yhs1202/ov7670-dice-race/constr/Basys-3-Master.xdc

## This file is a general .xdc for the Basys3 rev B board
## To use it in a project:
## - uncomment the lines corresponding to used pins
## - rename the used ports (in each line, after get_ports) according to the top level signal names in the project

## Clock signal
set_property -dict { PACKAGE_PIN W5   IOSTANDARD LVCMOS33 } [get_ports clk]
create_clock -add -name sys_clk_pin -period 10.00 -waveform {0 5} [get_ports clk]


## Switches
# set_property -dict { PACKAGE_PIN V17   IOSTANDARD LVCMOS33 } [get_ports {filter_sel[0]}]
# set_property -dict { PACKAGE_PIN V16   IOSTANDARD LVCMOS33 } [get_ports {filter_sel[1]}]
# set_property -dict { PACKAGE_PIN W16   IOSTANDARD LVCMOS33 } [get_ports {filter_sel[2]}]
# set_property -dict { PACKAGE_PIN W17   IOSTANDARD LVCMOS33 } [get_ports {filter_sel[3]}]
#set_property -dict { PACKAGE_PIN W15   IOSTANDARD LVCMOS33 } [get_ports {sw[4]}]
#set_property -dict { PACKAGE_PIN V15   IOSTANDARD LVCMOS33 } [get_ports {sw[5]}]
#set_property -dict { PACKAGE_PIN W14   IOSTANDARD LVCMOS33 } [get_ports {sw[6]}] 
#set_property -dict { PACKAGE_PIN W13   IOSTANDARD LVCMOS33 } [get_ports {sw[7]}]
#set_property -dict { PACKAGE_PIN V2    IOSTANDARD LVCMOS33 } [get_ports {sw[8]}]
#set_property -dict { PACKAGE_PIN T3    IOSTANDARD LVCMOS33 } [get_ports {sw[9]}]
#set_property -dict { PACKAGE_PIN T2    IOSTANDARD LVCMOS33 } [get_ports {sw[10]}]
#set_property -dict { PACKAGE_PIN R3    IOSTANDARD LVCMOS33 } [get_ports {sw[11]}]
#set_property -dict { PACKAGE_PIN W2    IOSTANDARD LVCMOS33 } [get_ports {sw[12]}]
#set_property -dict { PACKAGE_PIN U1    IOSTANDARD LVCMOS33 } [get_ports {sw[13]}]
#set_property -dict { PACKAGE_PIN T1    IOSTANDARD LVCMOS33 } [get_ports {sw[14]}]
#set_property -dict { PACKAGE_PIN R2    IOSTANDARD LVCMOS33 } [get_ports {sw[15]}]


## LEDs
set_property -dict { PACKAGE_PIN U16   IOSTANDARD LVCMOS33 } [get_ports {led_output[0]}]
set_property -dict { PACKAGE_PIN E19   IOSTANDARD LVCMOS33 } [get_ports {led_output[1]}]
set_property -dict { PACKAGE_PIN U19   IOSTANDARD LVCMOS33 } [get_ports {led_output[2]}]
set_property -dict { PACKAGE_PIN V19   IOSTANDARD LVCMOS33 } [get_ports {led_output[3]}]
set_property -dict { PACKAGE_PIN W18   IOSTANDARD LVCMOS33 } [get_ports {led_output[4]}]
set_property -dict { PACKAGE_PIN U15   IOSTANDARD LVCMOS33 } [get_ports {led_output[5]}]
set_property -dict { PACKAGE_PIN U14   IOSTANDARD LVCMOS33 } [get_ports {led_output[6]}]
set_property -dict { PACKAGE_PIN V14   IOSTANDARD LVCMOS33 } [get_ports {led_output[7]}]
set_property -dict { PACKAGE_PIN V13   IOSTANDARD LVCMOS33 } [get_ports {led_output[8]}]
set_property -dict { PACKAGE_PIN V3    IOSTANDARD LVCMOS33 } [get_ports {led_output[9]}]
set_property -dict { PACKAGE_PIN W3    IOSTANDARD LVCMOS33 } [get_ports {led_output[10]}]
set_property -dict { PACKAGE_PIN U3    IOSTANDARD LVCMOS33 } [get_ports {led_output[11]}]
set_property -dict { PACKAGE_PIN P3    IOSTANDARD LVCMOS33 } [get_ports {led_output[12]}]
set_property -dict { PACKAGE_PIN N3    IOSTANDARD LVCMOS33 } [get_ports {led_output[13]}]
set_property -dict { PACKAGE_PIN P1    IOSTANDARD LVCMOS33 } [get_ports {led_output[14]}]
set_property -dict { PACKAGE_PIN L1    IOSTANDARD LVCMOS33 } [get_ports {led_output[15]}]


##7 Segment Display
set_property -dict { PACKAGE_PIN W7   IOSTANDARD LVCMOS33 } [get_ports {fnd_data[0]}]
set_property -dict { PACKAGE_PIN W6   IOSTANDARD LVCMOS33 } [get_ports {fnd_data[1]}]
set_property -dict { PACKAGE_PIN U8   IOSTANDARD LVCMOS33 } [get_ports {fnd_data[2]}]
set_property -dict { PACKAGE_PIN V8   IOSTANDARD LVCMOS33 } [get_ports {fnd_data[3]}]
set_property -dict { PACKAGE_PIN U5   IOSTANDARD LVCMOS33 } [get_ports {fnd_data[4]}]
set_property -dict { PACKAGE_PIN V5   IOSTANDARD LVCMOS33 } [get_ports {fnd_data[5]}]
set_property -dict { PACKAGE_PIN U7   IOSTANDARD LVCMOS33 } [get_ports {fnd_data[6]}]

set_property -dict { PACKAGE_PIN V7   IOSTANDARD LVCMOS33 } [get_ports {fnd_data[7]}]

set_property -dict { PACKAGE_PIN U2   IOSTANDARD LVCMOS33 } [get_ports {fnd_com[0]}]
set_property -dict { PACKAGE_PIN U4   IOSTANDARD LVCMOS33 } [get_ports {fnd_com[1]}]
set_property -dict { PACKAGE_PIN V4   IOSTANDARD LVCMOS33 } [get_ports {fnd_com[2]}]
set_property -dict { PACKAGE_PIN W4   IOSTANDARD LVCMOS33 } [get_ports {fnd_com[3]}]


##Buttons
set_property -dict { PACKAGE_PIN U18   IOSTANDARD LVCMOS33 } [get_ports reset]; # center
set_property -dict { PACKAGE_PIN T18   IOSTANDARD LVCMOS33 } [get_ports start_btn]; # up
# set_property -dict { PACKAGE_PIN W19   IOSTANDARD LVCMOS33 } [get_ports dice_valid]; # left
# set_property -dict { PACKAGE_PIN T17   IOSTANDARD LVCMOS33 } [get_ports btnR]; # right
set_property -dict { PACKAGE_PIN U17   IOSTANDARD LVCMOS33 } [get_ports select_option]; # down



##Pmod Header JA
set_property -dict { PACKAGE_PIN J1   IOSTANDARD LVCMOS33 } [get_ports {CAM1_data[7]}];#Sch name = JA1
set_property -dict { PACKAGE_PIN L2   IOSTANDARD LVCMOS33 } [get_ports {CAM1_data[5]}];#Sch name = JA2
set_property -dict { PACKAGE_PIN J2   IOSTANDARD LVCMOS33 } [get_ports {CAM1_data[3]}];#Sch name = JA3
set_property -dict { PACKAGE_PIN G2   IOSTANDARD LVCMOS33 } [get_ports {CAM1_data[1]}];#Sch name = JA4
set_property -dict { PACKAGE_PIN H1   IOSTANDARD LVCMOS33 } [get_ports {CAM1_data[6]}];#Sch name = JA7
set_property -dict { PACKAGE_PIN K2   IOSTANDARD LVCMOS33 } [get_ports {CAM1_data[4]}];#Sch name = JA8
set_property -dict { PACKAGE_PIN H2   IOSTANDARD LVCMOS33 } [get_ports {CAM1_data[2]}];#Sch name = JA9
set_property -dict { PACKAGE_PIN G3   IOSTANDARD LVCMOS33 } [get_ports {CAM1_data[0]}];#Sch name = JA10

##Pmod Header JB
set_property -dict { PACKAGE_PIN A14   IOSTANDARD LVCMOS33 } [get_ports {CAM1_sioc}];#Sch name = JB1
set_property -dict { PACKAGE_PIN A16   IOSTANDARD LVCMOS33 } [get_ports {CAM1_vsync}];#Sch name = JB2
#set_property -dict { PACKAGE_PIN B15   IOSTANDARD LVCMOS33 } [get_ports {JB[2]}];#Sch name = JB3
#set_property -dict { PACKAGE_PIN B16   IOSTANDARD LVCMOS33 } [get_ports {JB[3]}];#Sch name = JB4
set_property -dict { PACKAGE_PIN A15   IOSTANDARD LVCMOS33 } [get_ports {CAM1_siod}];#Sch name = JB7
set_property -dict { PACKAGE_PIN A17   IOSTANDARD LVCMOS33 } [get_ports {CAM1_href}];#Sch name = JB8
set_property -dict { PACKAGE_PIN C15   IOSTANDARD LVCMOS33 } [get_ports {CAM1_xclk}];#Sch name = JB9
set_property -dict { PACKAGE_PIN C16   IOSTANDARD LVCMOS33 } [get_ports {CAM1_pclk}];#Sch name = JB10

# ##Pmod Header JC
set_property -dict { PACKAGE_PIN K17   IOSTANDARD LVCMOS33 } [get_ports {CAM2_sioc}];#Sch name = JC1
set_property -dict { PACKAGE_PIN M18   IOSTANDARD LVCMOS33 } [get_ports {CAM2_vsync}];#Sch name = JC2
set_property -dict { PACKAGE_PIN N17   IOSTANDARD LVCMOS33 } [get_ports {CAM2_pclk}];#Sch name = JC3
# set_property -dict { PACKAGE_PIN P18   IOSTANDARD LVCMOS33 } [get_ports {JB}];#Sch name = JC4
set_property -dict { PACKAGE_PIN L17   IOSTANDARD LVCMOS33 } [get_ports {CAM2_siod}];#Sch name = JC7
set_property -dict { PACKAGE_PIN M19   IOSTANDARD LVCMOS33 } [get_ports {CAM2_href}];#Sch name = JC8
set_property -dict { PACKAGE_PIN P17   IOSTANDARD LVCMOS33 } [get_ports {CAM2_xclk}];#Sch name = JC9
# set_property -dict { PACKAGE_PIN R18   IOSTANDARD LVCMOS33 } [get_ports {pclk_Player}];#Sch name = JC10

# ##Pmod Header JXADC
set_property -dict { PACKAGE_PIN J3   IOSTANDARD LVCMOS33 } [get_ports {CAM2_data[7]}];#Sch name = XA1_P
set_property -dict { PACKAGE_PIN L3   IOSTANDARD LVCMOS33 } [get_ports {CAM2_data[5]}];#Sch name = XA2_P
set_property -dict { PACKAGE_PIN M2   IOSTANDARD LVCMOS33 } [get_ports {CAM2_data[3]}];#Sch name = XA3_P
set_property -dict { PACKAGE_PIN N2   IOSTANDARD LVCMOS33 } [get_ports {CAM2_data[1]}];#Sch name = XA4_P
set_property -dict { PACKAGE_PIN K3   IOSTANDARD LVCMOS33 } [get_ports {CAM2_data[6]}];#Sch name = XA1_N
set_property -dict { PACKAGE_PIN M3   IOSTANDARD LVCMOS33 } [get_ports {CAM2_data[4]}];#Sch name = XA2_N
set_property -dict { PACKAGE_PIN M1   IOSTANDARD LVCMOS33 } [get_ports {CAM2_data[2]}];#Sch name = XA3_N
set_property -dict { PACKAGE_PIN N1   IOSTANDARD LVCMOS33 } [get_ports {CAM2_data[0]}];#Sch name = XA4_N


##VGA Connector
set_property -dict { PACKAGE_PIN G19   IOSTANDARD LVCMOS33 } [get_ports {r_port[0]}]
set_property -dict { PACKAGE_PIN H19   IOSTANDARD LVCMOS33 } [get_ports {r_port[1]}]
set_property -dict { PACKAGE_PIN J19   IOSTANDARD LVCMOS33 } [get_ports {r_port[2]}]
set_property -dict { PACKAGE_PIN N19   IOSTANDARD LVCMOS33 } [get_ports {r_port[3]}]
set_property -dict { PACKAGE_PIN N18   IOSTANDARD LVCMOS33 } [get_ports {b_port[0]}]
set_property -dict { PACKAGE_PIN L18   IOSTANDARD LVCMOS33 } [get_ports {b_port[1]}]
set_property -dict { PACKAGE_PIN K18   IOSTANDARD LVCMOS33 } [get_ports {b_port[2]}]
set_property -dict { PACKAGE_PIN J18   IOSTANDARD LVCMOS33 } [get_ports {b_port[3]}]
set_property -dict { PACKAGE_PIN J17   IOSTANDARD LVCMOS33 } [get_ports {g_port[0]}]
set_property -dict { PACKAGE_PIN H17   IOSTANDARD LVCMOS33 } [get_ports {g_port[1]}]
set_property -dict { PACKAGE_PIN G17   IOSTANDARD LVCMOS33 } [get_ports {g_port[2]}]
set_property -dict { PACKAGE_PIN D17   IOSTANDARD LVCMOS33 } [get_ports {g_port[3]}]
set_property -dict { PACKAGE_PIN P19   IOSTANDARD LVCMOS33 } [get_ports h_sync]
set_property -dict { PACKAGE_PIN R19   IOSTANDARD LVCMOS33 } [get_ports v_sync]


##USB-RS232 Interface
#set_property -dict { PACKAGE_PIN B18   IOSTANDARD LVCMOS33 } [get_ports RsRx]
#set_property -dict { PACKAGE_PIN A18   IOSTANDARD LVCMOS33 } [get_ports RsTx]


##USB HID (PS/2)
# set_property -dict { PACKAGE_PIN C17   IOSTANDARD LVCMOS33   PULLUP true } [get_ports SCL]
# set_property -dict { PACKAGE_PIN B17   IOSTANDARD LVCMOS33   PULLUP true } [get_ports SDA]


##Quad SPI Flash
##Note that CCLK_0 cannot be placed in 7 series devices. You can access it using the
##STARTUPE2 primitive.
#set_property -dict { PACKAGE_PIN D18   IOSTANDARD LVCMOS33 } [get_ports {QspiDB[0]}]
#set_property -dict { PACKAGE_PIN D19   IOSTANDARD LVCMOS33 } [get_ports {QspiDB[1]}]
#set_property -dict { PACKAGE_PIN G18   IOSTANDARD LVCMOS33 } [get_ports {QspiDB[2]}]
#set_property -dict { PACKAGE_PIN F18   IOSTANDARD LVCMOS33 } [get_ports {QspiDB[3]}]
#set_property -dict { PACKAGE_PIN K19   IOSTANDARD LVCMOS33 } [get_ports QspiCSn]


## Configuration options, can be used for all designs
set_property CONFIG_VOLTAGE 3.3 [current_design]
set_property CFGBVS VCCO [current_design]

## SPI configuration mode options for QSPI boot, can be used for all designs
set_property BITSTREAM.GENERAL.COMPRESS TRUE [current_design]
set_property BITSTREAM.CONFIG.CONFIGRATE 33 [current_design]
set_property CONFIG_MODE SPIx4 [current_design]

## Clock Dedicated Route for Non-Clock Capable Pins (PMOD)
# set_property CLOCK_DEDICATED_ROUTE FALSE [get_nets OV7670_pclk_IBUF]
# set_property CLOCK_DEDICATED_ROUTE FALSE [get_nets OV7670_pclk2_IBUF]
