yhs1202/ov7670-dice-race/src/ov7670_driver/pixel_clk_gen.sv

`timescale 1ns / 1ps

module pixel_clk_gen (
    input  logic clk,
    input  logic reset,
    output logic pclk
);
    logic [1:0] p_counter;

    always_ff @(posedge clk, posedge reset) begin
        if (reset) begin
            p_counter <= 0;
        end else begin
            if (p_counter == 3) begin   
                p_counter <= 0;
                pclk      <= 1'b1;
            end else begin
                p_counter <= p_counter + 1;
                pclk      <= 1'b0;
            end
        end
    end
endmodule
