yhs1202/ov7670-dice-race/src/game_logic/fnd_driver/mux_4x1.sv

`timescale 1ns / 1ps
module mux_4x1 (
    input [3:0] digit_1,
    input [3:0] digit_10,
    input [3:0] digit_100,
    input [3:0] digit_1000,
    input [1:0] sel,
    output reg [3:0] bcd
);

    always @(*) begin
        case (sel)
            2'b00: bcd = digit_1;
            2'b01: bcd = digit_10;
            2'b10: bcd = digit_100;
            2'b11: bcd = digit_1000;
            default: bcd = digit_1;
        endcase
    end
endmodule
