yhs1202/ov7670-dice-race/src/ui_render/font_rom.sv

`timescale 1ns/1ps

// 8x8 Pixel Font ROM
// Supports ASCII characters for retro game display
module font_rom (
    input  logic [7:0] char_code,   // ASCII character code
    input  logic [2:0] row,         // Row within character (0-7)
    output logic [7:0] font_line    // 8 pixels for this row
);

    always_comb begin
        font_line = 8'h00;  // Default: empty
        
        case (char_code)
            // ===== Special Characters =====
            // Arrow/Cursor (0x10)
            8'h10: case (row)
                3'd0: font_line = 8'b00100000;
                3'd1: font_line = 8'b00110000;
                3'd2: font_line = 8'b00111000;
                3'd3: font_line = 8'b00111100;
                3'd4: font_line = 8'b00111000;
                3'd5: font_line = 8'b00110000;
                3'd6: font_line = 8'b00100000;
                3'd7: font_line = 8'b00000000;
            endcase
            
            // Space (0x20)
            8'h20: font_line = 8'h00;
            
            // ! (0x21)
            8'h21: case (row)
                3'd0: font_line = 8'b00011000;
                3'd1: font_line = 8'b00011000;
                3'd2: font_line = 8'b00011000;
                3'd3: font_line = 8'b00011000;
                3'd4: font_line = 8'b00011000;
                3'd5: font_line = 8'b00000000;
                3'd6: font_line = 8'b00011000;
                3'd7: font_line = 8'b00000000;
            endcase
            
            // - (0x2D)
            8'h2D: case (row)
                3'd0: font_line = 8'b00000000;
                3'd1: font_line = 8'b00000000;
                3'd2: font_line = 8'b00000000;
                3'd3: font_line = 8'b01111110;
                3'd4: font_line = 8'b00000000;
                3'd5: font_line = 8'b00000000;
                3'd6: font_line = 8'b00000000;
                3'd7: font_line = 8'b00000000;
            endcase
            
            // ===== Numbers 0-9 =====
            // 0
            8'h30: case (row)
                3'd0: font_line = 8'b00111100;
                3'd1: font_line = 8'b01100110;
                3'd2: font_line = 8'b01101110;
                3'd3: font_line = 8'b01110110;
                3'd4: font_line = 8'b01100110;
                3'd5: font_line = 8'b01100110;
                3'd6: font_line = 8'b00111100;
                3'd7: font_line = 8'b00000000;
            endcase
            
            // 1
            8'h31: case (row)
                3'd0: font_line = 8'b00011000;
                3'd1: font_line = 8'b00111000;
                3'd2: font_line = 8'b00011000;
                3'd3: font_line = 8'b00011000;
                3'd4: font_line = 8'b00011000;
                3'd5: font_line = 8'b00011000;
                3'd6: font_line = 8'b01111110;
                3'd7: font_line = 8'b00000000;
            endcase
            
            // 2
            8'h32: case (row)
                3'd0: font_line = 8'b00111100;
                3'd1: font_line = 8'b01100110;
                3'd2: font_line = 8'b00000110;
                3'd3: font_line = 8'b00011100;
                3'd4: font_line = 8'b00110000;
                3'd5: font_line = 8'b01100000;
                3'd6: font_line = 8'b01111110;
                3'd7: font_line = 8'b00000000;
            endcase
            
            // 3
            8'h33: case (row)
                3'd0: font_line = 8'b00111100;
                3'd1: font_line = 8'b01100110;
                3'd2: font_line = 8'b00000110;
                3'd3: font_line = 8'b00011100;
                3'd4: font_line = 8'b00000110;
                3'd5: font_line = 8'b01100110;
                3'd6: font_line = 8'b00111100;
                3'd7: font_line = 8'b00000000;
            endcase
            
            // 4
            8'h34: case (row)
                3'd0: font_line = 8'b00001100;
                3'd1: font_line = 8'b00011100;
                3'd2: font_line = 8'b00101100;
                3'd3: font_line = 8'b01001100;
                3'd4: font_line = 8'b01111110;
                3'd5: font_line = 8'b00001100;
                3'd6: font_line = 8'b00001100;
                3'd7: font_line = 8'b00000000;
            endcase
            
            // 5
            8'h35: case (row)
                3'd0: font_line = 8'b01111110;
                3'd1: font_line = 8'b01100000;
                3'd2: font_line = 8'b01111100;
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
            
            // Y
            8'h59: case (row)
                3'd0: font_line = 8'b01100110;
                3'd1: font_line = 8'b01100110;
                3'd2: font_line = 8'b01100110;
                3'd3: font_line = 8'b00111100;
                3'd4: font_line = 8'b00011000;
                3'd5: font_line = 8'b00011000;
                3'd6: font_line = 8'b00011000;
                3'd7: font_line = 8'b00000000;
            endcase
            
            // Z
            8'h5A: case (row)
                3'd0: font_line = 8'b01111110;
                3'd1: font_line = 8'b00000110;
                3'd2: font_line = 8'b00001100;
                3'd3: font_line = 8'b00011000;
                3'd4: font_line = 8'b00110000;
                3'd5: font_line = 8'b01100000;
                3'd6: font_line = 8'b01111110;
                3'd7: font_line = 8'b00000000;
            endcase
            
            default: font_line = 8'h00;
        endcase
    end

endmodule
