yhs1202/ov7670-dice-race/(commit log)

2025-11-26 Refactor I2C to handle ACK_error
2025-11-29 Update Basys-3 constraints for dice value and LED outputs
2025-11-29 Fix player position limits and update win event flag in game logic
    [game_logic.sv]
2025-11-30 event 3 bug fix
    [game_logic.sv]
2025-12-01 refactor: rename 'rst' to 'reset'
    [btn_debounce.v]
2025-12-01 1st integrate Camera system and update signal connections
2025-12-01 integrate RGB selector module, update Camera_system module to use 12-bit RGB output format
2025-12-02 Add ASCII filter
2025-12-02 Update filter_sel to 4 bits in Img_Filter and DiceRace_System; adjust pin mapping in Basys-3-Master.xdc
2025-12-03 Fisheye_Filter bit 수정
2025-12-03 Remove unused comments in Camera_system module
2025-12-03 Fixed bug: event_flag and filter selection Connection
    [Basys-3-Master.xdc, DiceRace_System.sv, Game_Logic_Controller.sv, Img_Filter.sv]
2025-12-03 filter fix
2025-12-03 Change LED output indication for winner
2025-12-04 GREEN_G_MIN 수정
